Khrystarlite/Poppy_Right_Arm_Creature/README.md

# Poppy Right Arm (WORK IN PROGRESS!)

Watch PoppyRightArm in action! :

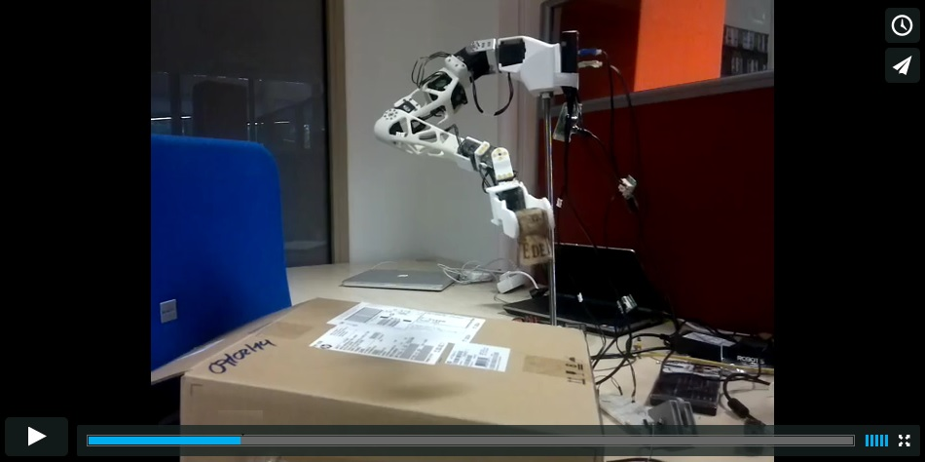
[picture p1: doc/img/video.jpg]
Little red ridning hood (https://vimeo.com/134843436 "Little red riding hood - Click to Watch!")


## [Documentation »](https://github.com/joelortizsosa/Poppy_Right_Arm_Creature/blob/master/doc/README.md)
## [STL View »](doc/stl/PoppyRightArm.STL)

## Credit

The beginning of this project was inspired from the project [Poppy Humanoid](https://www.poppy-project.org/?lang=fr). This project was conceived to simulate an upper limb prostheses. In this [link](https://vimeo.com/134840606) you can watch an EMG control of Poppy Humanoid where this projectt will replace all Poppy humanoid to use only the part of interest.

This project is in charge of the research center [INRIA](http://www.inria.fr/centre/bordeaux) in collaboration of [INCIA](http://www.incia.u-bordeaux1.fr/)

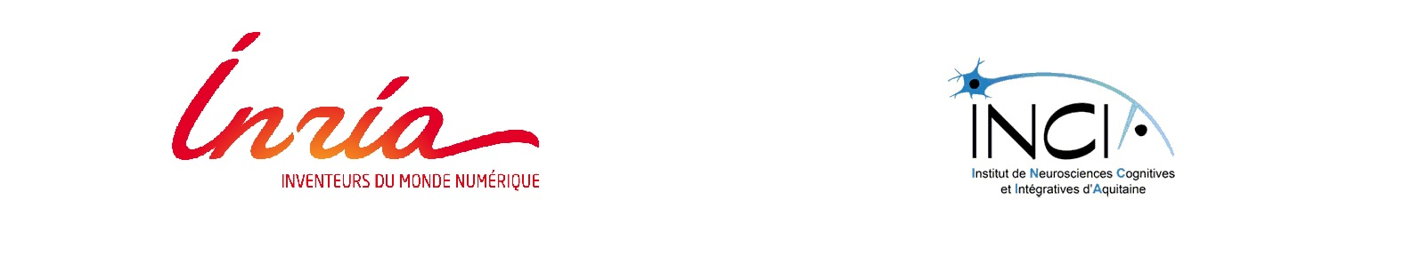
[picture p2: doc/img/credits.jpg]
credits
