Khrystarlite/Poppy_Right_Arm_Creature/doc/README.md

# Poppy Right Arm documentation

<p align="center">
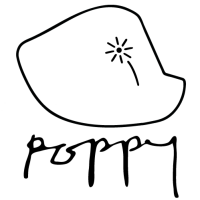
[picture p3: doc/img/logo.png]
Poppy_logo.

</p>

In this documentation you will find everything you need to assemble your own arm from scratch:

## [Assembly »]( https://github.com/joelortizsosa/Poppy_Right_Arm_Creature/blob/master/doc/assembly.md)

In this section we explain, how you can assembly all the hadware ....

## [Electronic »]( https://github.com/joelortizsosa/Poppy_Right_Arm_Creature/blob/master/doc/electronic.md)

In this section we explain, how you can power up all the motors ....

## [Software »]( https://github.com/joelortizsosa/Poppy_Right_Arm_Creature/blob/master/doc/software.md)

In this section we explain, how you can install the creature necessary to control Poppy_Right_Arm, and we show some applications  ....

## [Common Bug »]( https://github.com/joelortizsosa/Poppy_Right_Arm_Creature/blob/master/doc/common_Bug.md)

If you have any trouble when you execute your code, you can try watch this section ...
