Khrystarlite/Poppy_Right_Arm_Creature/Hardware/Poppy_arm_gripper/Components/morceau_2.SLDPRT

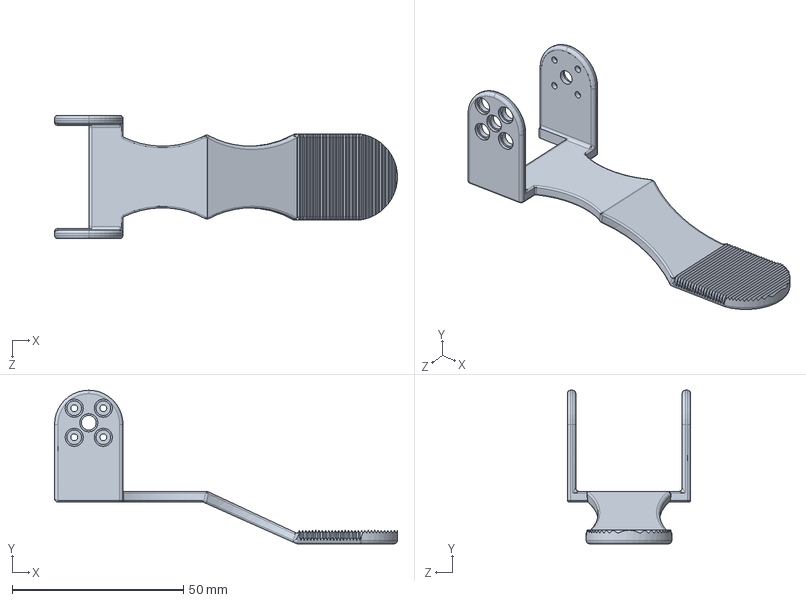
[picture p12: CAD file, 2015-07-27]
Hardware/Poppy_arm_gripper/Components/morceau_2.SLDPRT
100.0 x 44.8 x 36.0 mm
