Khrystarlite/Poppy_Right_Arm_Creature/Hardware/Poppy_arm_gripper/Components/STL/shift_one_side.stl

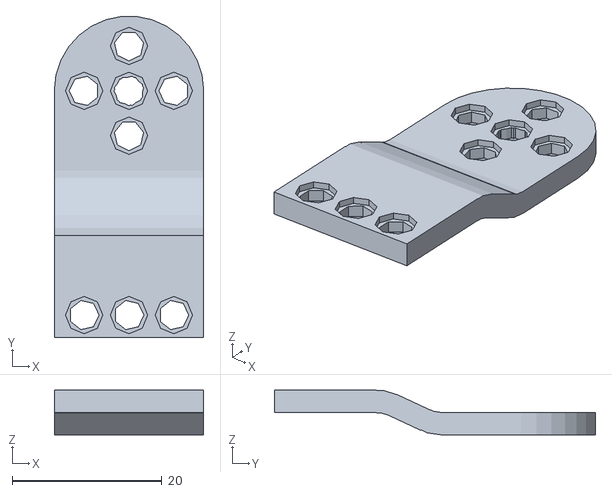
[picture p13: CAD file, 2015-07-27]
Hardware/Poppy_arm_gripper/Components/STL/shift_one_side.stl
20.0 x 42.9 x 6.00
