Khrystarlite/Poppy_Right_Arm_Creature/Hardware/Poppy_arm_gripper/Components/STL/support_Bras_droit_mod1.STL

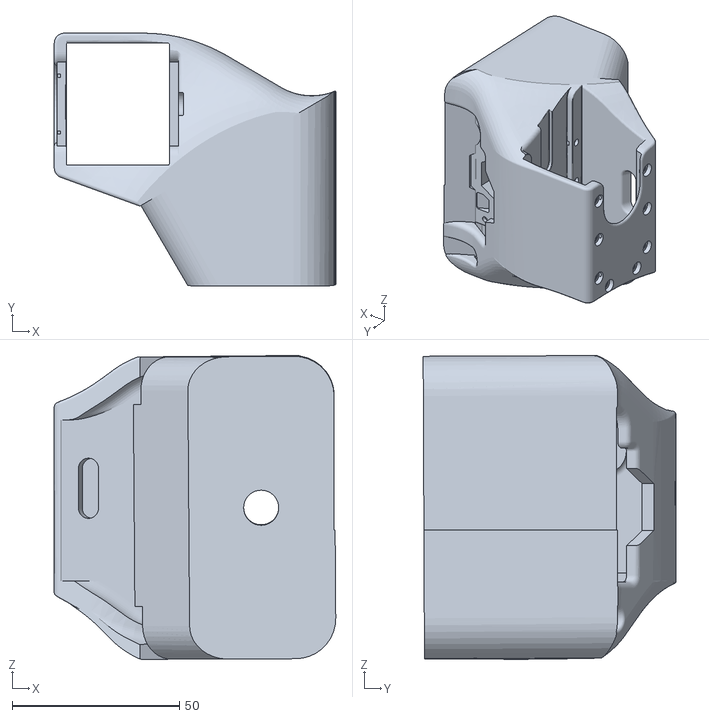
[picture p14: CAD file, 2015-07-27]
Hardware/Poppy_arm_gripper/Components/STL/support_Bras_droit_mod1.STL
84.2 x 75.6 x 90.9
