Khrystarlite/Poppy_Right_Arm_Creature/Hardware/Poppy_arm_gripper/Components/supp_3.SLDPRT

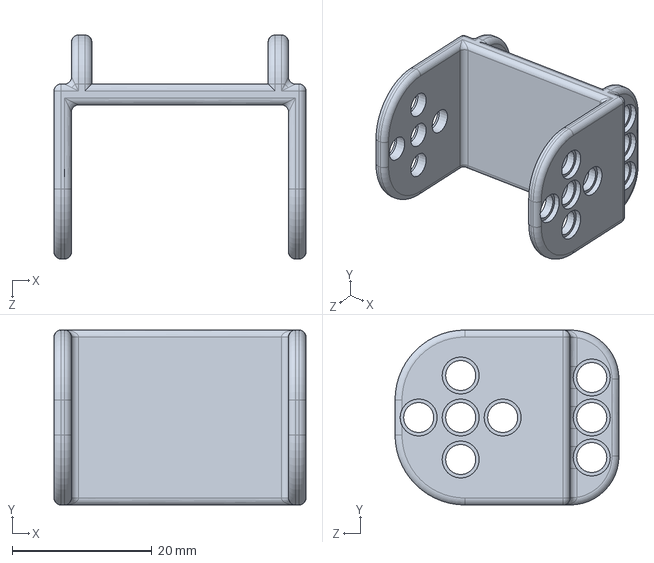
[picture p15: CAD file, 2015-07-27]
Hardware/Poppy_arm_gripper/Components/supp_3.SLDPRT
36.0 x 25.0 x 32.0 mm
