Khrystarlite/Poppy_Right_Arm_Creature/Hardware/Poppy_arm_gripper/Components/STL/forearm.STL

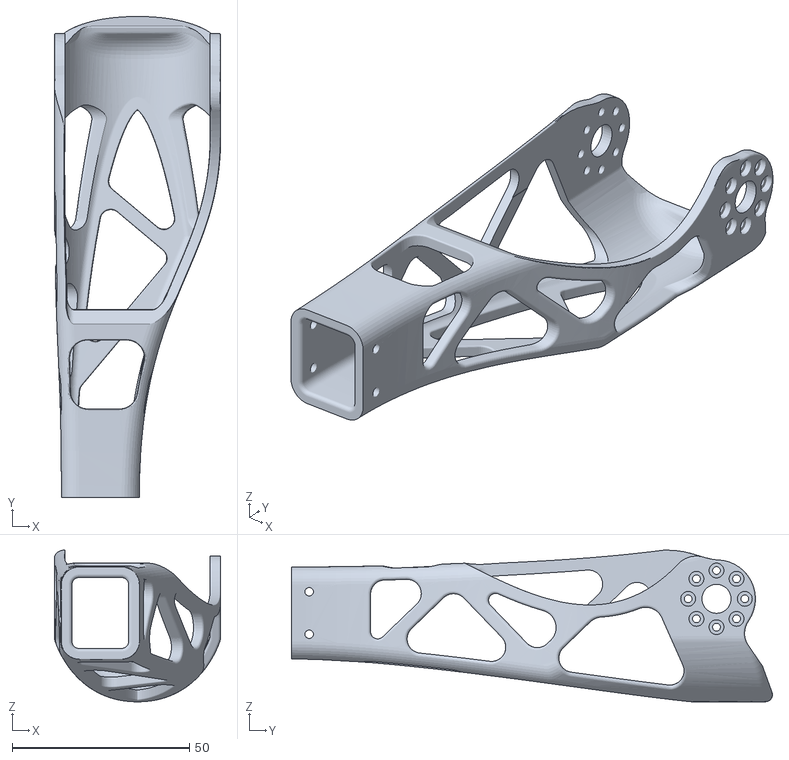
[picture p16: CAD file, 2015-07-27]
Hardware/Poppy_arm_gripper/Components/STL/forearm.STL
47.0 x 135.8 x 42.8
