Khrystarlite/Poppy_Right_Arm_Creature/Hardware/Poppy_arm_gripper/Components/supp_1.SLDPRT

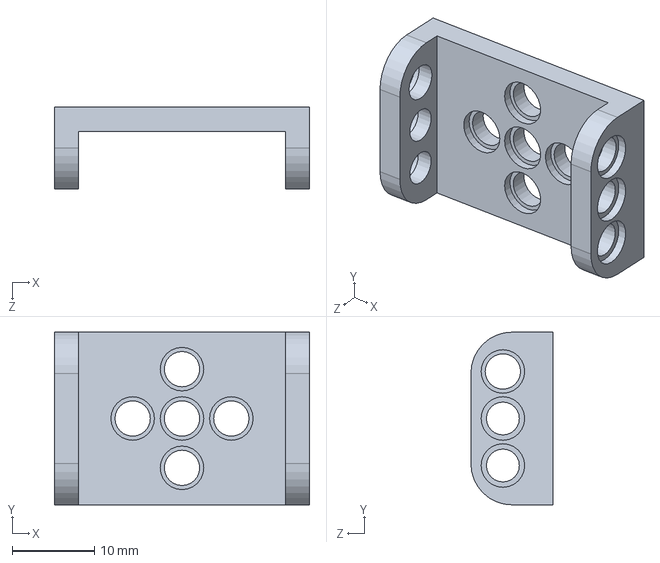
[picture p17: CAD file, 2015-07-27]
Hardware/Poppy_arm_gripper/Components/supp_1.SLDPRT
31.0 x 21.0 x 10.0 mm
