Khrystarlite/Poppy_Right_Arm_Creature/Hardware/Poppy_arm_gripper/Components/STL/support_gripper.STL

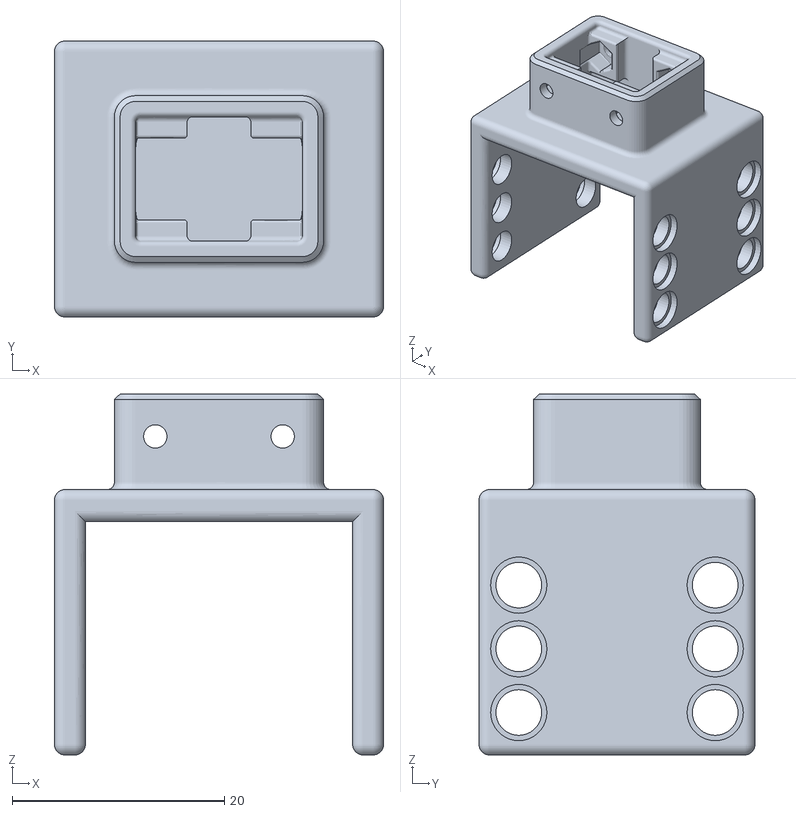
[picture p18: CAD file, 2015-07-27]
Hardware/Poppy_arm_gripper/Components/STL/support_gripper.STL
31.0 x 26.0 x 34.0
