Khrystarlite/Poppy_Right_Arm_Creature/Hardware/Poppy_arm_gripper/Components/supp_2.SLDPRT

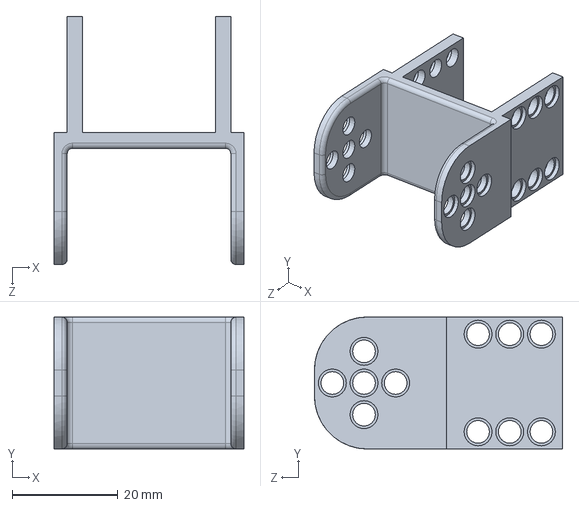
[picture p19: CAD file, 2015-07-27]
Hardware/Poppy_arm_gripper/Components/supp_2.SLDPRT
36.0 x 25.0 x 47.0 mm
