Khrystarlite/Poppy_Right_Arm_Creature/Hardware/Poppy_arm_gripper/Components/morceau_1.SLDPRT

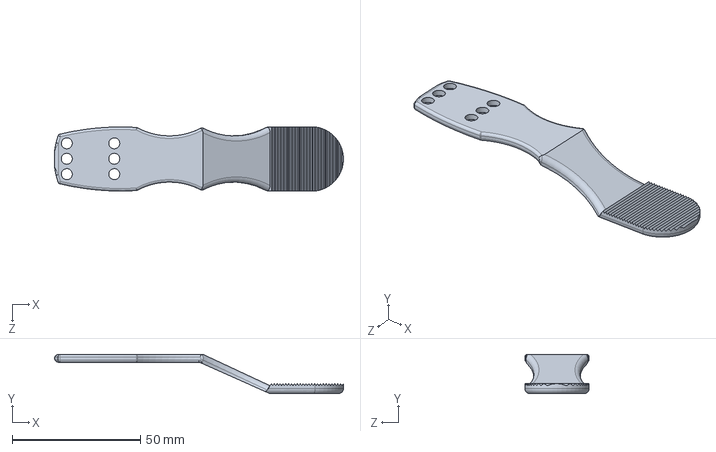
[picture p20: CAD file, 2015-07-27]
Hardware/Poppy_arm_gripper/Components/morceau_1.SLDPRT
112.6 x 15.3 x 25.0 mm
