Khrystarlite/Poppy_Right_Arm_Creature/Hardware/Poppy_arm_gripper/Components/support_for_table.SLDPRT

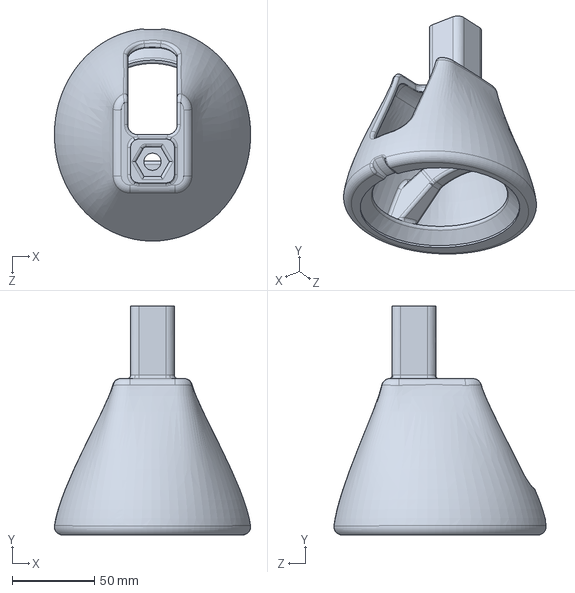
[picture p21: CAD file, 2015-07-26]
Hardware/Poppy_arm_gripper/Components/support_for_table.SLDPRT
119.1 x 139.0 x 128.8 mm
