Khrystarlite/Poppy_Right_Arm_Creature/Hardware/Poppy_arm_gripper/Components/shoulder.SLDPRT

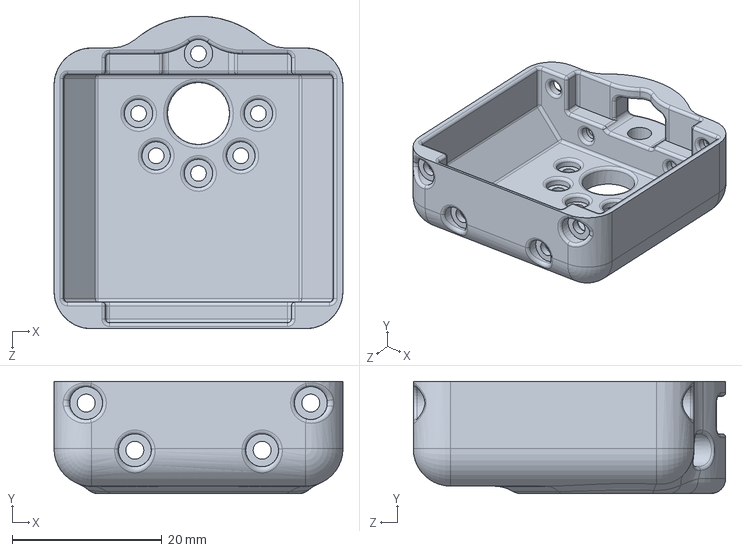
[picture p22: CAD file, 2015-05-19]
Hardware/Poppy_arm_gripper/Components/shoulder.SLDPRT
38.6 x 15.0 x 41.7 mm
