Khrystarlite/Poppy_Right_Arm_Creature/Hardware/Poppy_arm_gripper/Components/upper_arm.SLDPRT

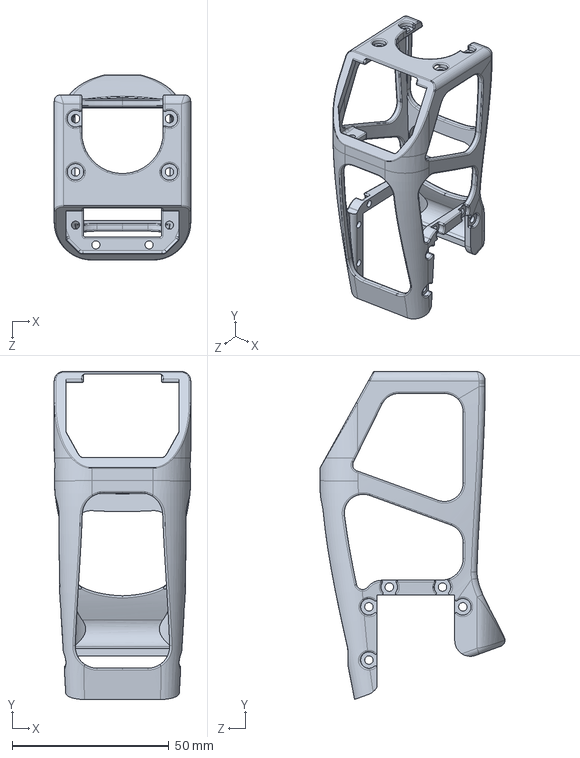
[picture p23: CAD file, 2015-05-19]
Hardware/Poppy_arm_gripper/Components/upper_arm.SLDPRT
43.6 x 104.7 x 59.1 mm
