Khrystarlite/Poppy_Right_Arm_Creature/(list of files, cad)

Other CAD files:
Hardware/Poppy_arm_gripper/Components/STL/morceau_1.STL
Hardware/Poppy_arm_gripper/Components/STL/morceau_2.STL
Hardware/Poppy_arm_gripper/Components/STL/shoulder.STL
Hardware/Poppy_arm_gripper/Components/STL/supp_1.STL
Hardware/Poppy_arm_gripper/Components/STL/supp_2.STL
Hardware/Poppy_arm_gripper/Components/STL/supp_3.STL
Hardware/Poppy_arm_gripper/Components/STL/support_for_table.STL
Hardware/Poppy_arm_gripper/Components/STL/upper_arm.STL
