Khrystarlite/Poppy_Right_Arm_Creature/doc/assembly.md

# Step by Step Assembly

## BOM

For building a Poppy right Arm, you will need:

* 5x robotis [XL-320] (http://www.generationrobots.com/en/401692-dynamixel-xl-320-servo-motor.html?search_query=OLLO&results=23)
* 10x [XL cable](http://www.generationrobots.com/en/402090-3p-130-mm-cables-for-xl-servos-x5.html)
* 2x [USB2AX] (http://www.generationrobots.com/en/401584-usb2ax-for-dynamixel-servos.html?search_query=usb2aX&results=5)
* 4x robotics [MX-28] (http://www.generationrobots.com/en/401080-dynamixel-mx-28t-actuator-robotis.html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)
* 2x HN07-I101 [Horn](http://www.generationrobots.com/en/400939-hn07-i101-horn-and-bearing-set-for-dynamixel-actuators-robotis.html)
* 1x FR07-H101K [Set] (http://www.generationrobots.com/en/400917-fr07-h101k-set-robotis.html?search_query=FR07-H101K&results=2)
* 1x [TTL cable](http://www.generationrobots.com/en/401739-3p-cable-set-bcs-3p01-for-dynamixel-servo-motors.html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)
* 1x small electronic board (see the [electronic section](electronic.md))
* 1x [Power Supply 12V - 5A] (http://www.trossenrobotics.com/p/power-supply-12vdc-5a.aspx)
* the 3D printed parts: [STL] (https://github.com/joelortizsosa/Poppy_bras_Creatures/releases) [BOM](https://github.com/joelortizsosa/Poppy_bras_Creatures/blob/master/Hadware/Poppy%20bras%20prehenseur/BOM.md)
* 1x [threaded shaft](http://www.leroymerlin.fr/v3/p/produits/tige-filetee-en-acier-zingue-long-1-m-x-diam-10-mm-e54322) D:10mm L: min 45 cm
* 4x [Hex Nut](http://www.vis-express.fr/fr/ecrous-inox-a2-hu/19735-ECROU-HEXAGONAL-M10-INOX-DACROMET-8425001057.html) D:10 mm
* 1x [OLLO Pulley-L](http://www.generationrobots.com/en/401871-ollo-pulley-l-gray-5pcs.html?search_query=OLLO&results=23) and their rivets
* many [OLLO rivets](http://www.generationrobots.com/en/401870-ollo-rivet-set-ors-10.html)
* 1x [OLLO Tool](http://www.generationrobots.com/en/401872-ollo-tool.html)
* 1x[100mm with lever arm suction pad](http://www.ventouses-soufflets.com/ventouses-avec-levier-d-appui/54-ventouse-100mm-avec-levier-d-appui-et-avec-patte-de-fixation-noire.html)
* 2x M5 nuts
* 2X M5x20mm screws
* 4x Bolt PHS M2x6 
* 4x N1 Nut M2 

### Visserie Optional:
* 1x Wrench Bolt M2.5*6 (200 pcs)
* 1x Nut M2.5 (400 pcs)

## Assembling your robot

## Step 1

First for assambly the poppy right arm we can use poppy basic arms [Doc] (https://github.com/poppy-project/Poppy-basic-arms/blob/master/doc/right_arm_assembly_instructions.md)

## Step 2
Mount the arm of step 1, motor MX-28, FR07 and threaded shaft on the 3D printed suppport.

Always align the horn with the motor before assembling them (red circle)

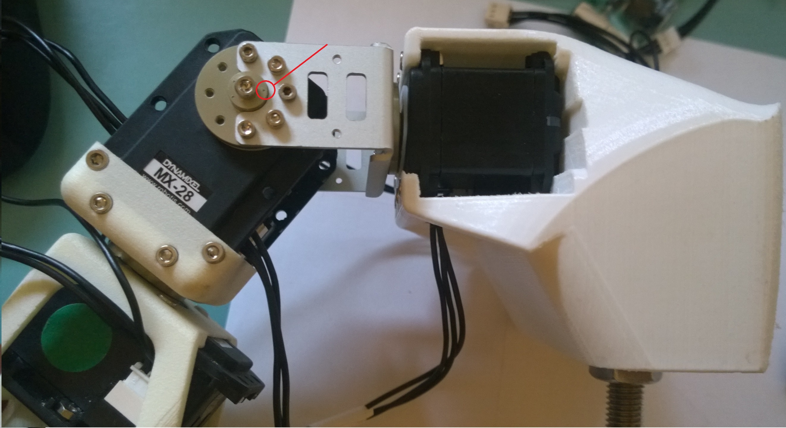
[picture p24: doc/img/assembly/img12.jpg]


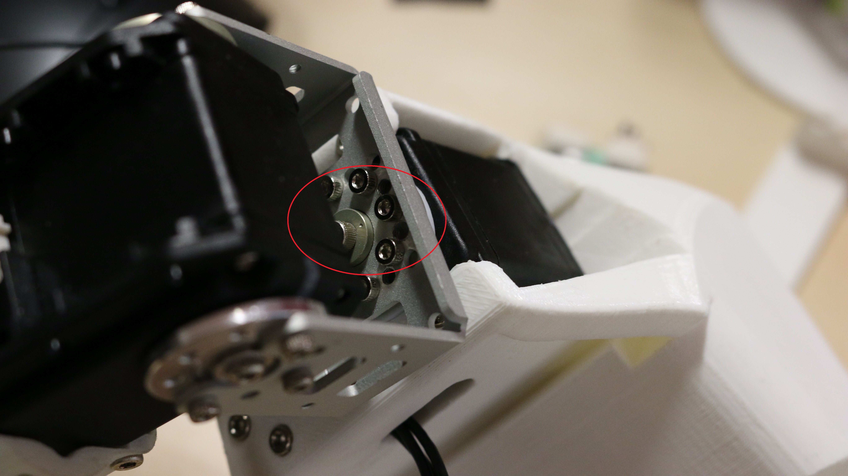
[picture p25: doc/img/assembly/img0.JPG]


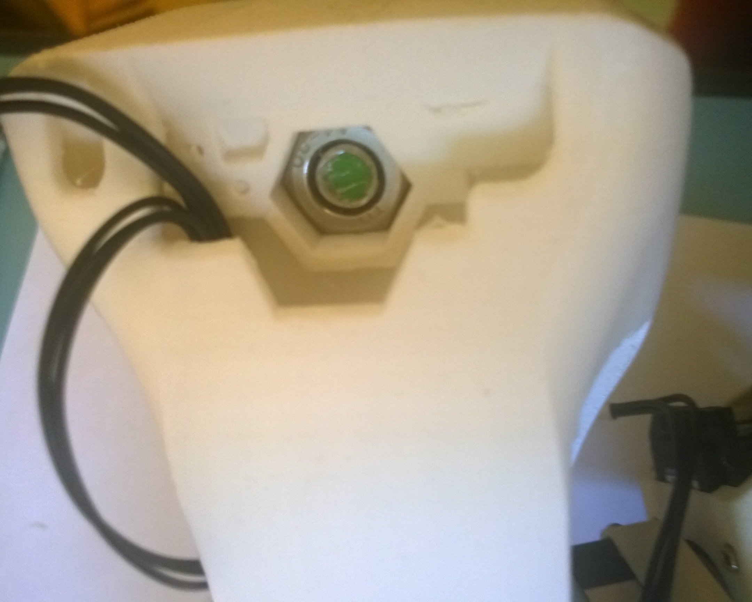
[picture p26: doc/img/assembly/img13.jpg]
step2_2


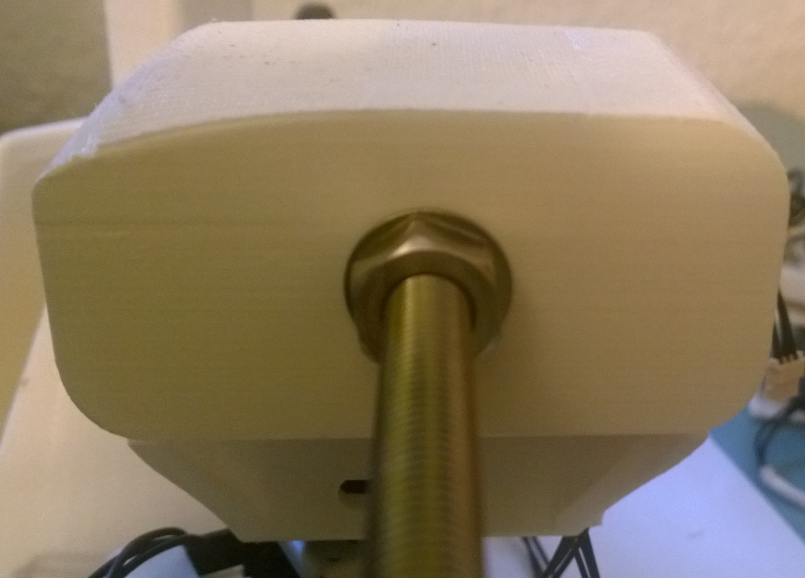
[picture p27: doc/img/assembly/img14.jpg]
step2_3


## Step 3

Mount step 2 in the support for table.

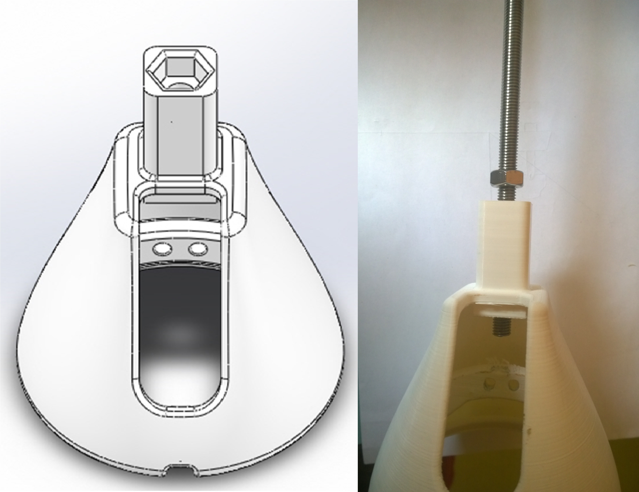
[picture p28: doc/img/assembly/support_for_table.jpg]
step3_1


## Step 4

Mount the suction pad inside the support for table

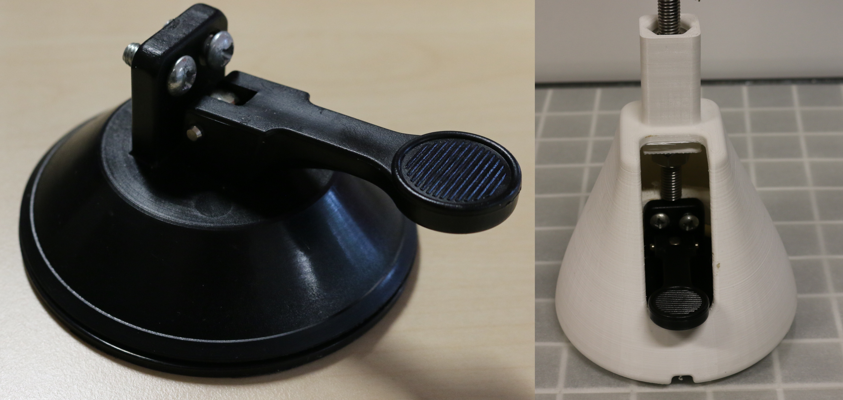
[picture p29: doc/img/assembly/base.jpg]
step4_1


## Step 5

Now you just need to mount the gripper, for do it, you have 3 possibilities each one gives the robot an additional degree of freedom.

3 degree of freedom without taking into account pronation and supination

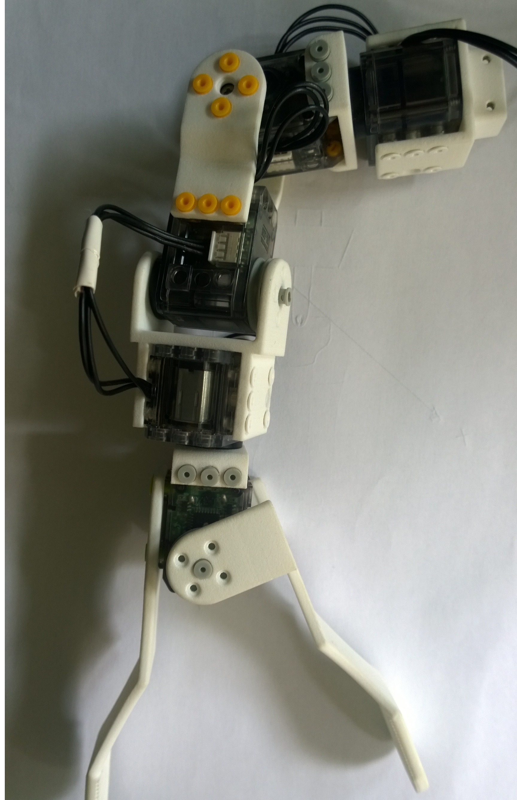
[picture p30: doc/img/assembly/img1.jpg]
step5_1


To mount some pieces you need the OLLO Pulley, you can watch how connect each OLLO Pulley [slow motion](https://vimeo.com/125704291).

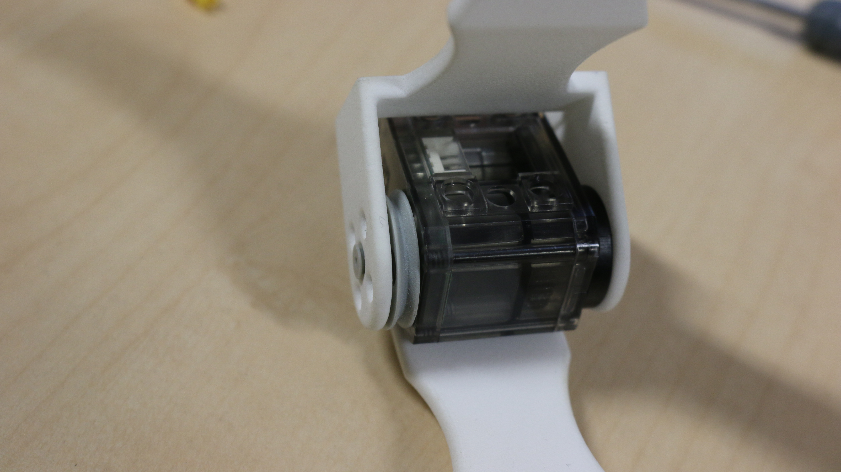
[picture p31: doc/img/assembly/pulley.JPG]
step5_2


## Step 6
To mount each piece you need many rivets,You can look at the following pictures how you can mount it.

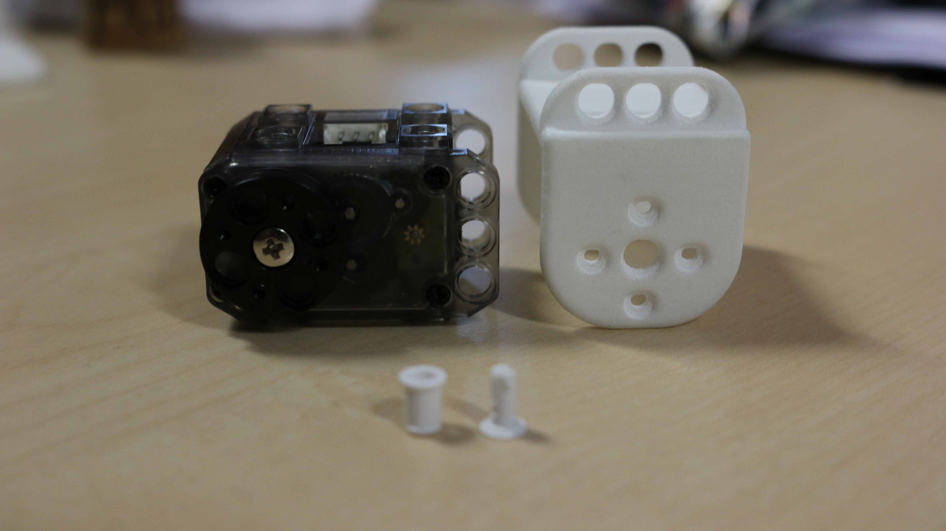
[picture p32: doc/img/assembly/rivet1.JPG]
step6_1


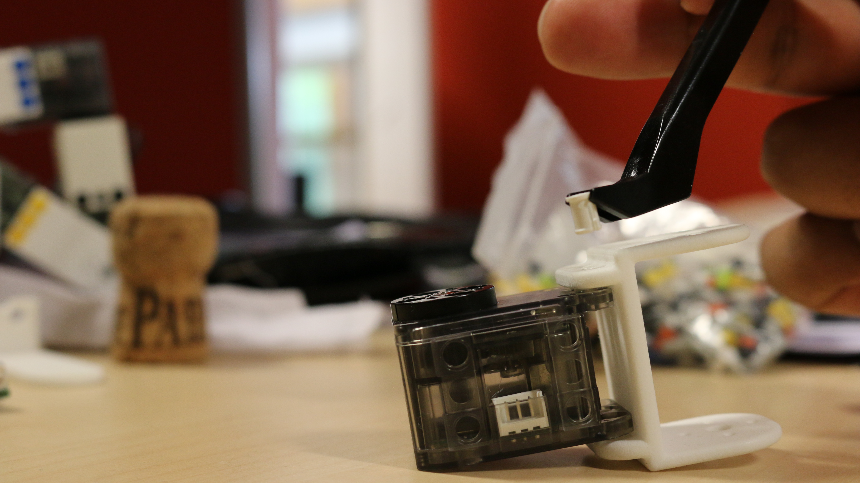
[picture p33: doc/img/assembly/rivet2.JPG]
step6_2


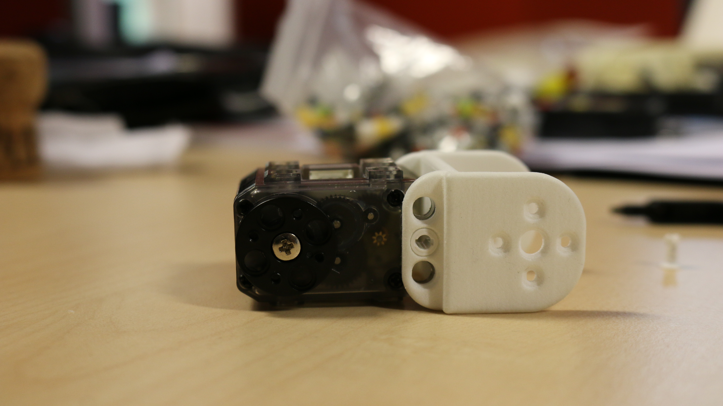
[picture p34: doc/img/assembly/rivet3.JPG]
step6_3


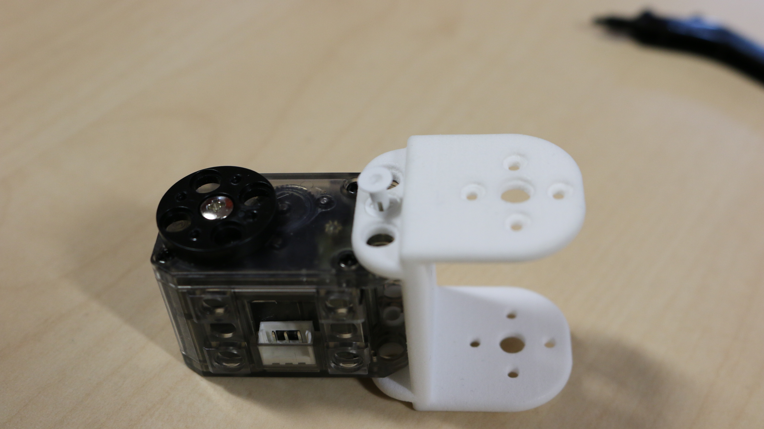
[picture p35: doc/img/assembly/rivet5.JPG]
step6_5


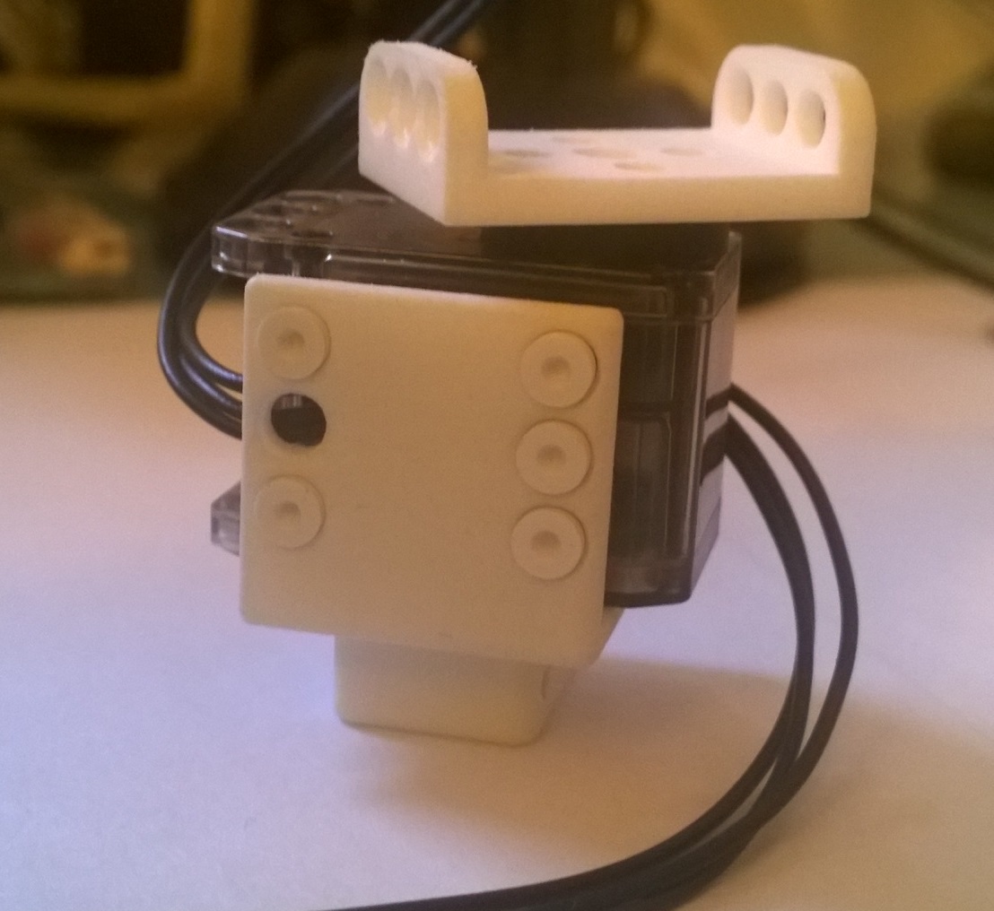
[picture p36: doc/img/assembly/img15.jpg]
step6_6


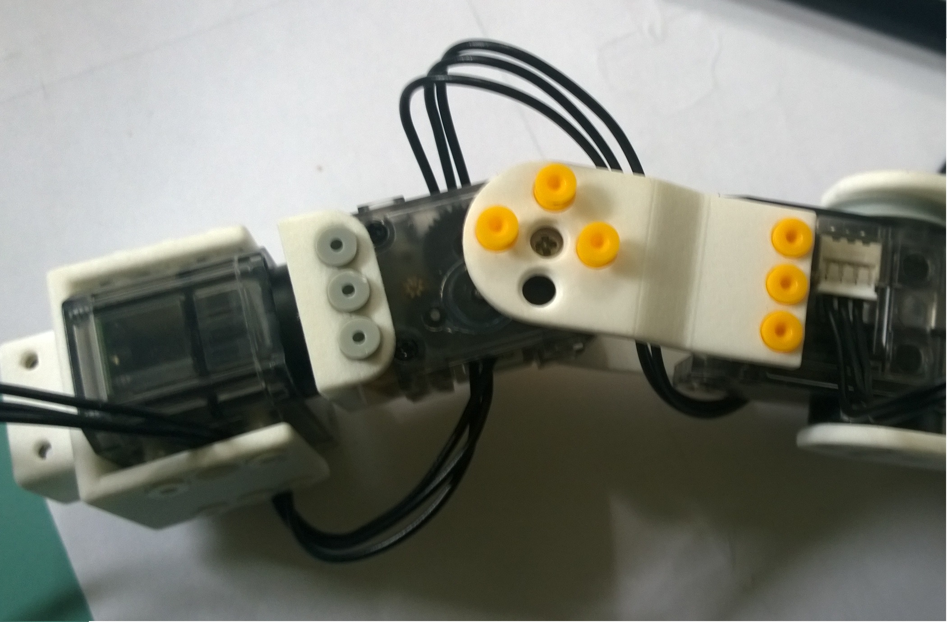
[picture p37: doc/img/assembly/img8.jpg]
step6_7


## Finally ...

<p align="center">

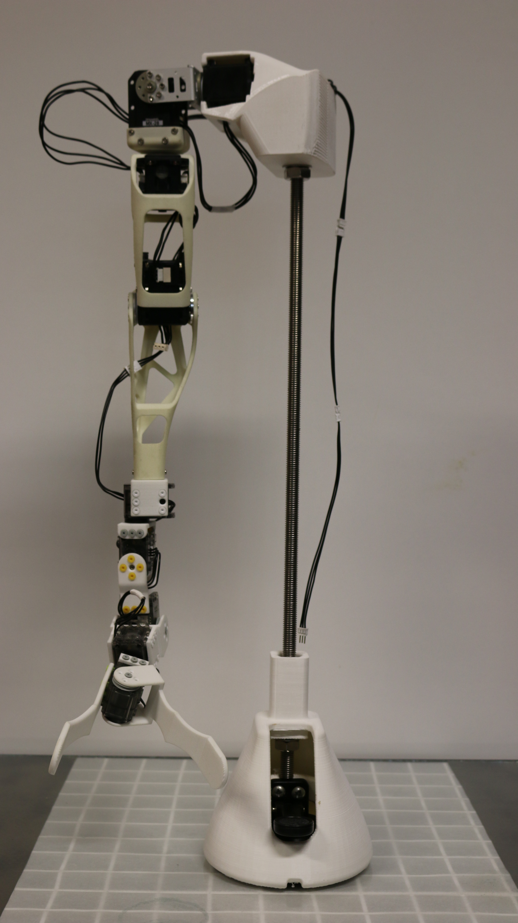
[picture p38: doc/img/assembly/pop_all.jpg]

</p>

## [Electronic »]( https://github.com/joelortizsosa/Poppy_Right_Arm_Creature/blob/master/doc/electronic.md)
