Khrystarlite/Poppy_Right_Arm_Creature/doc/img/assembly/img2.jpg

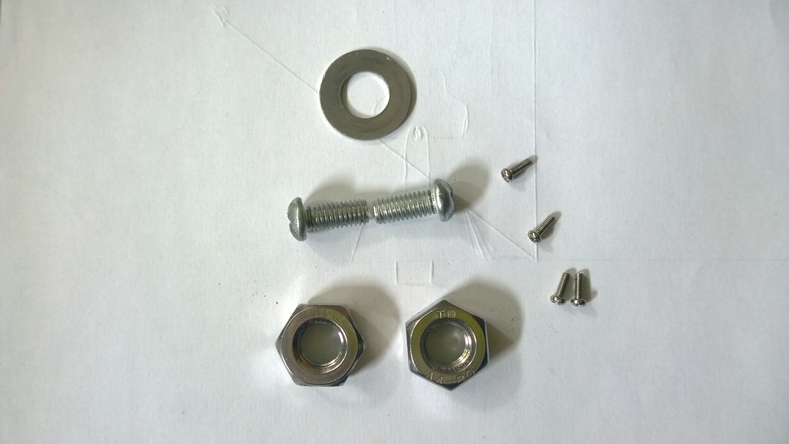
doc/img/assembly/img2.jpg
