Khrystarlite/Poppy_Right_Arm_Creature/doc/img/assembly/img3.jpg

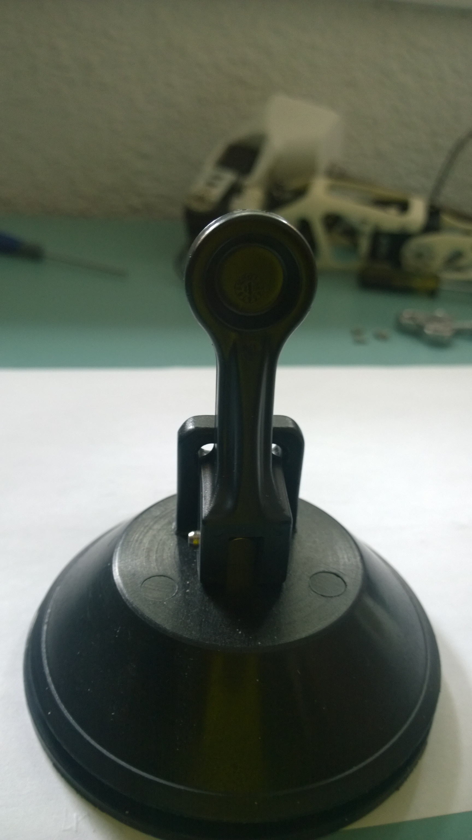
doc/img/assembly/img3.jpg
