Khrystarlite/Poppy_Right_Arm_Creature/doc/img/assembly/img4.jpg

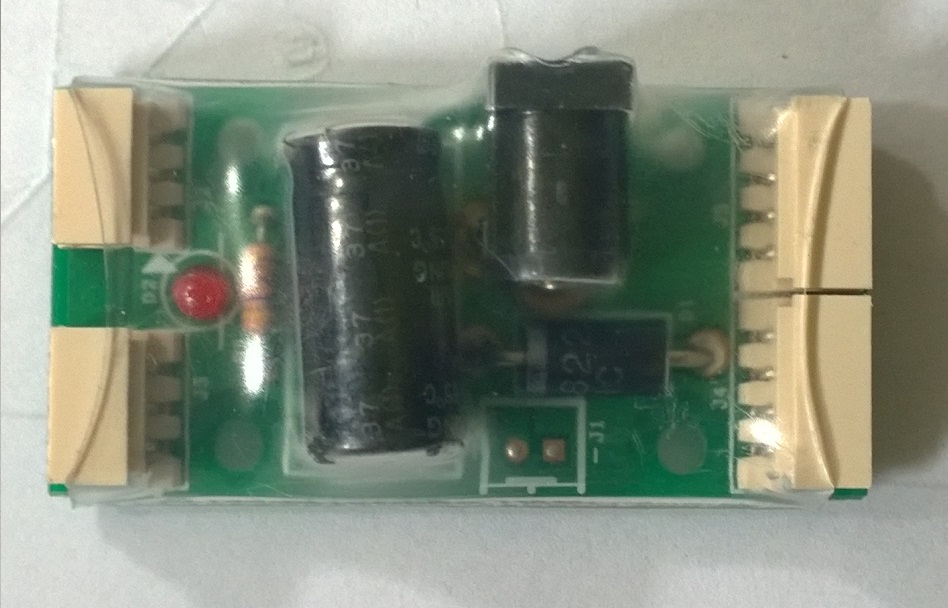
doc/img/assembly/img4.jpg
