Khrystarlite/Poppy_Right_Arm_Creature/doc/img/assembly/img5.jpg

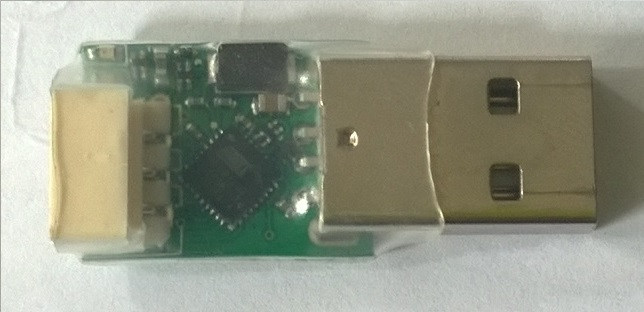
doc/img/assembly/img5.jpg
