Khrystarlite/Poppy_Right_Arm_Creature/doc/img/assembly/img6.jpg

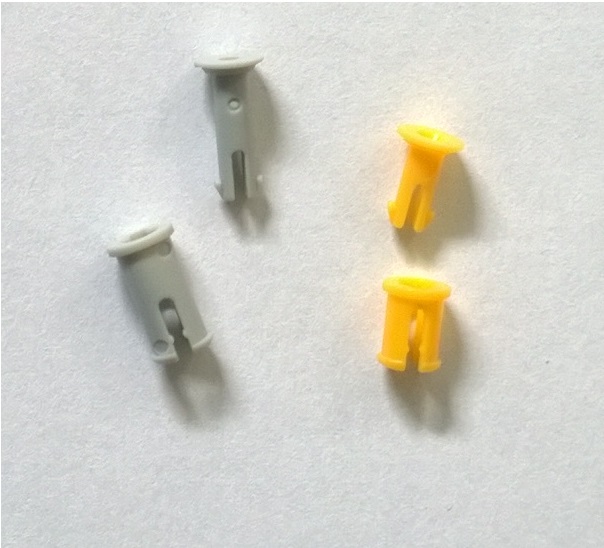
doc/img/assembly/img6.jpg
