Khrystarlite/Poppy_Right_Arm_Creature/doc/img/assembly/img7.jpg

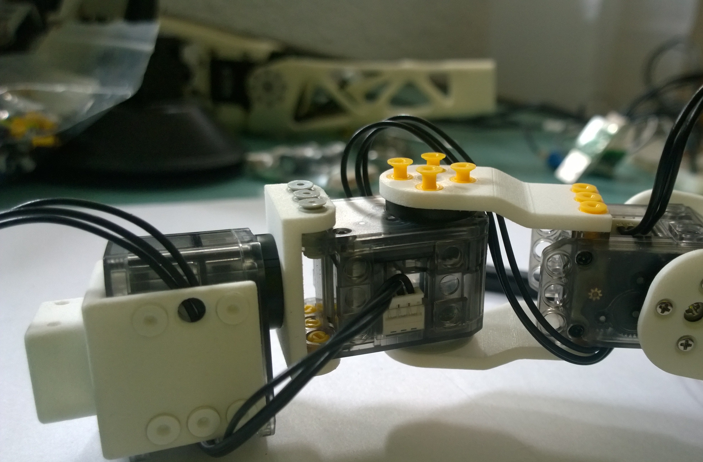
doc/img/assembly/img7.jpg
