Khrystarlite/Poppy_Right_Arm_Creature/doc/img/assembly/img9.jpg

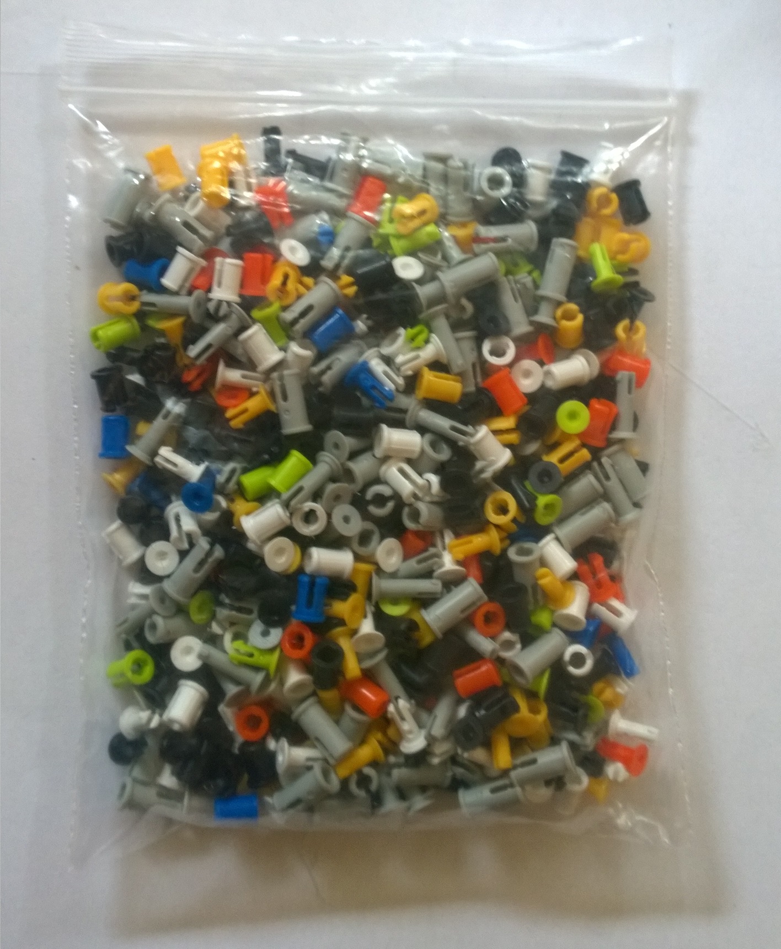
doc/img/assembly/img9.jpg
