Khrystarlite/Poppy_Right_Arm_Creature/doc/img/assembly/img10.jpg

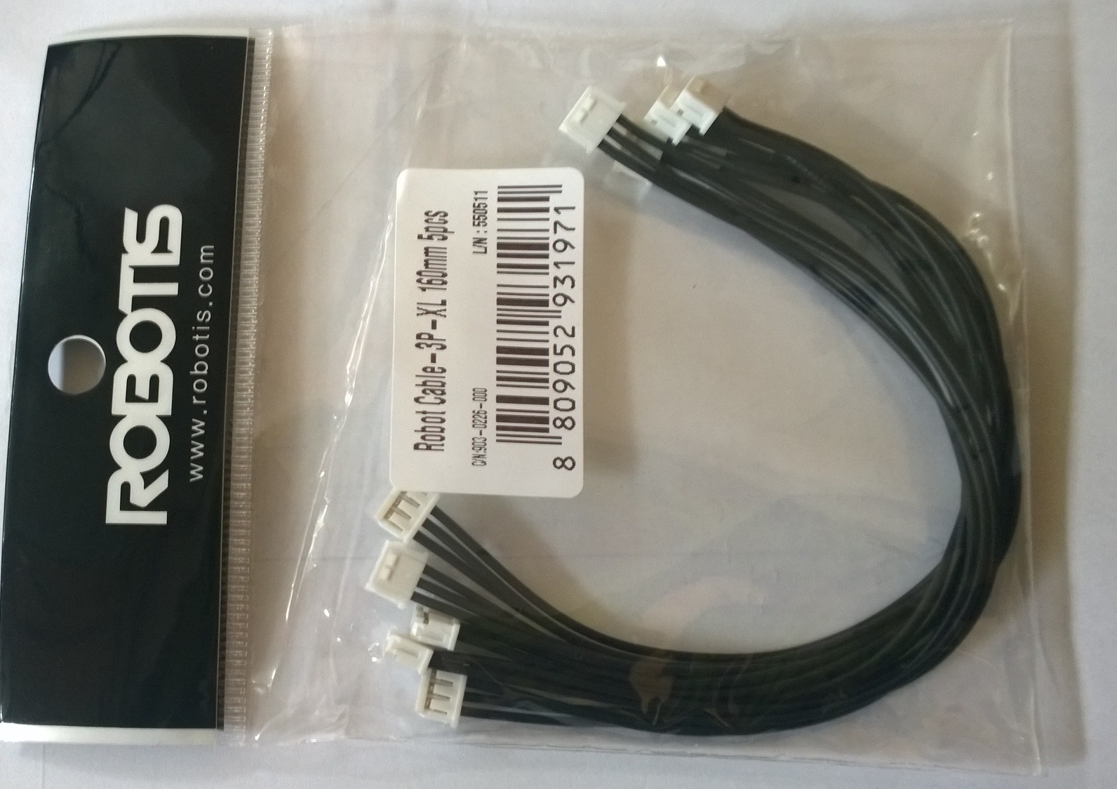
doc/img/assembly/img10.jpg
