Khrystarlite/Poppy_Right_Arm_Creature/doc/img/assembly/img11.jpg

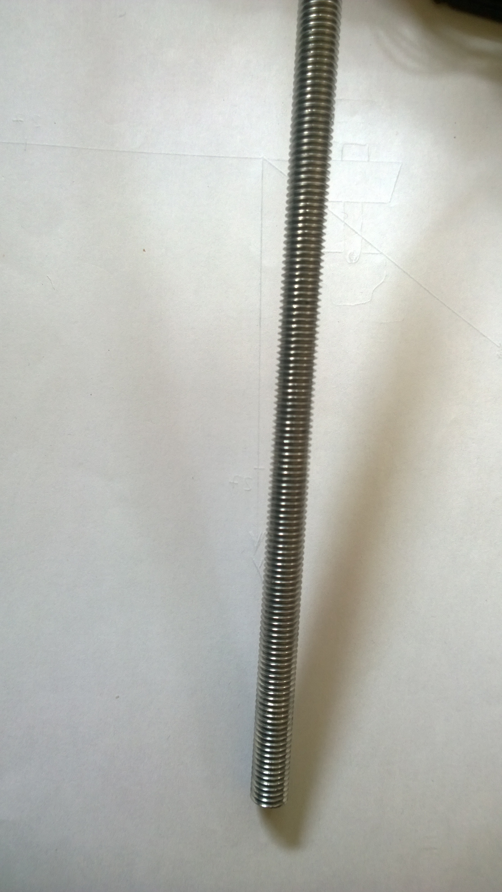
doc/img/assembly/img11.jpg
