Khrystarlite/Poppy_Right_Arm_Creature/doc/img/assembly/rivet4.JPG

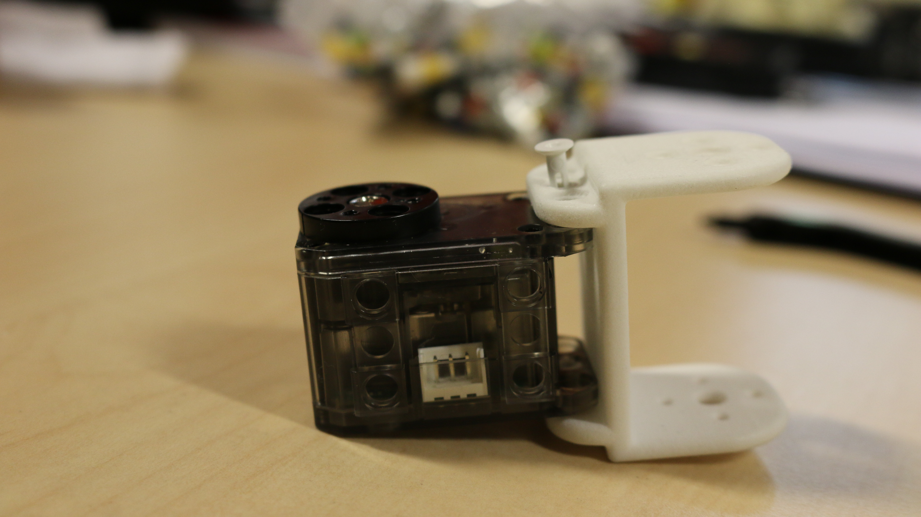
doc/img/assembly/rivet4.JPG
