Khrystarlite/Poppy_Right_Arm_Creature/doc/img/assembly/rivet6.JPG

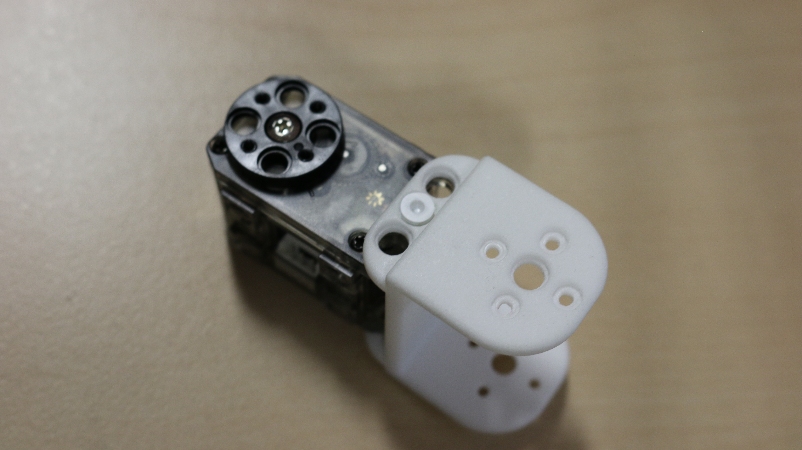
doc/img/assembly/rivet6.JPG
