Khrystarlite/Poppy_Right_Arm_Creature/Software/poppy_right_arm/primitives/posture.py

from __future__ import division

import time
import itertools

import pypot.primitive


class InitPosition(pypot.primitive.Primitive):
    '''
    Simple primitive so Poppy Torso moves to an initial posture, ready for the show !
    '''
    def run(self):
        self.robot.compliant = False
        self.robot.power_up()

        self.robot.goto_position(dict(zip((m.name for m in self.robot.motors), itertools.repeat(0))), 3, wait=True)

        time.sleep(0.5)
