Khrystarlite/Poppy_Right_Arm_Creature/(commit log)

2015-04-30 Poppy Bras Droit
    control bras droit de poppy
2015-05-17 cambio de medida
    changement de mesure
    [agarre_pinza.SLDPRT]
2015-05-19 modification pour le force
    [41750-sodemann.sldprt, Ensamblaje_pince.SLDASM, Pince_piece1.SLDPRT, Pince_piece1.STL, Pince_piece2.SLDPRT, Pince_piece2.STL, agarre_pinza.SLDPRT, agarre_pinza.STL]
2015-05-19 modification du force
    [Ensamblaje_pince.SLDASM, Pince_piece2.SLDPRT]
2015-07-26 Hadware support modfications
    [Ensamblaje_pince.SLDASM, support_for_table.STL]
2015-07-26 new img
    [support_for_table.SLDPRT]
2015-07-26 Enable/disable motors
2015-07-27 poppy stl
2015-07-27 hadware modification
    [41750-sodemann.sldprt, AX12_horn.SLDPRT, Ensamblaje_pince.SLDASM, F3.SLDPRT, Pince_piece1.SLDPRT, Pince_piece1.STL, Pince_piece2.SLDPRT, Pince_piece2.STL]
2015-07-27 modification of file
    [forearm.STL, morceau_1.SLDPRT, morceau_1.STL, morceau_2.SLDPRT, morceau_2.STL, shift_one_side.stl, shoulder.SLDPRT, shoulder.STL]
2016-11-09 data folders
    [Lugia.csv, beat_times.csv, record_0.csv]
2016-11-10 remote commit -Troi
    [Lugia.csv, record_0.csv]
2016-12-01 wav export check
    [Lugia.csv]
2016-12-02 calculated frame rate ratio
2016-12-05 memory error
    [tmp.csv]
2016-12-06 org && limiter
    [Lugia.csv, beat_times.csv, record_0.csv, tmp.csv]
2016-12-17 rattle_shake sample
2017-01-19 threading success
